wstarzak/quickTuneHF/imgs/CPU_board.png

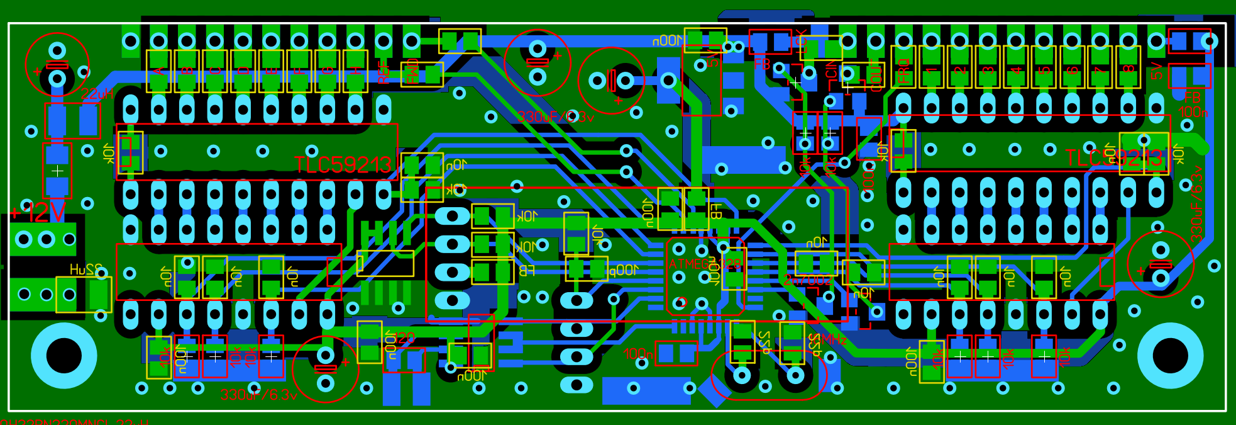
imgs/CPU_board.png
