wstarzak/quickTuneHF/imgs/IMG_8424.JPG

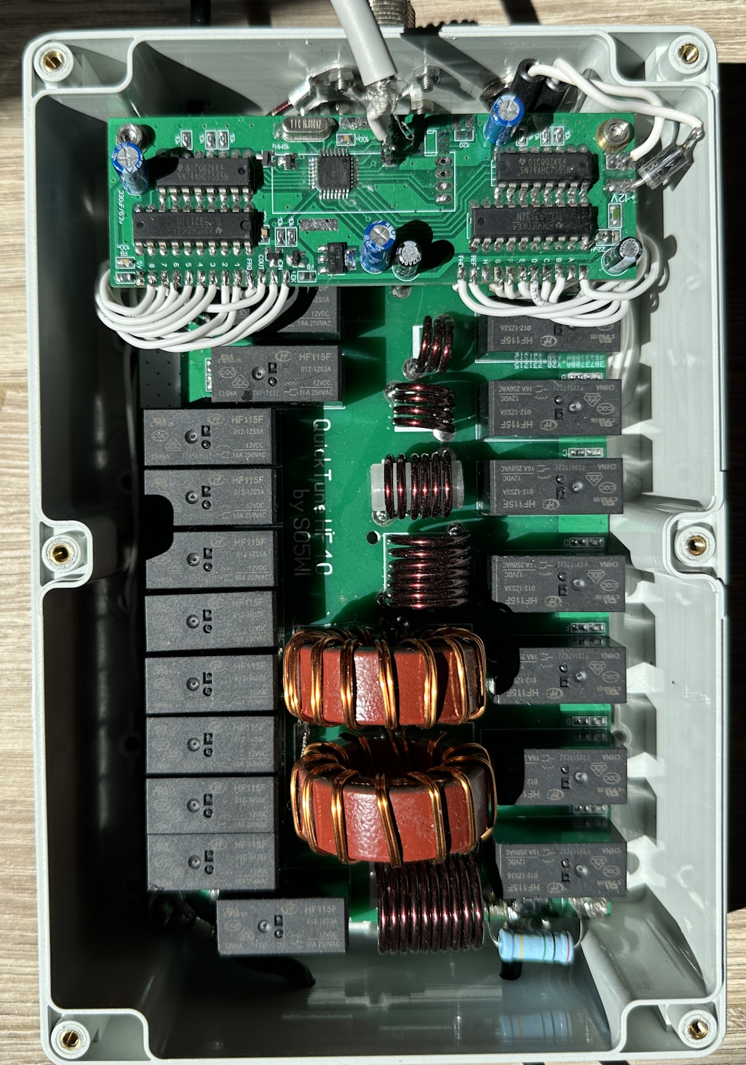
imgs/IMG_8424.JPG
