wstarzak/quickTuneHF/imgs/IMG_8435.JPG

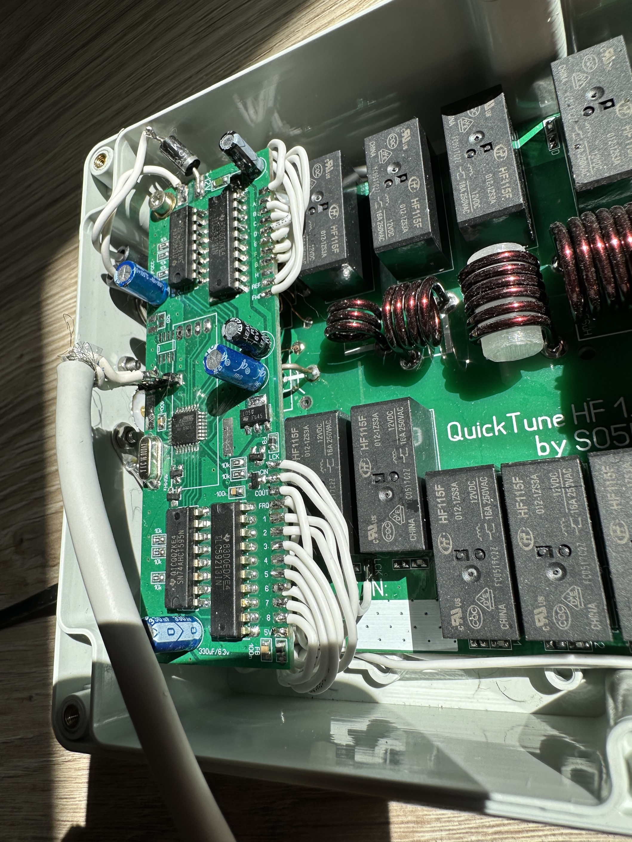
imgs/IMG_8435.JPG
