wstarzak/quickTuneHF/imgs/IMG_8436.JPG

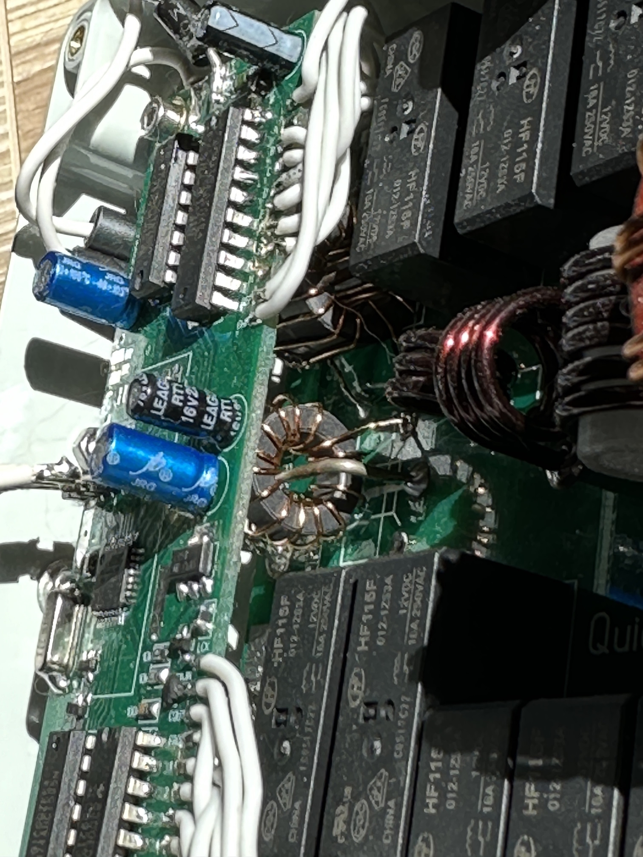
imgs/IMG_8436.JPG
