wstarzak/quickTuneHF/imgs/mainboard.JPG

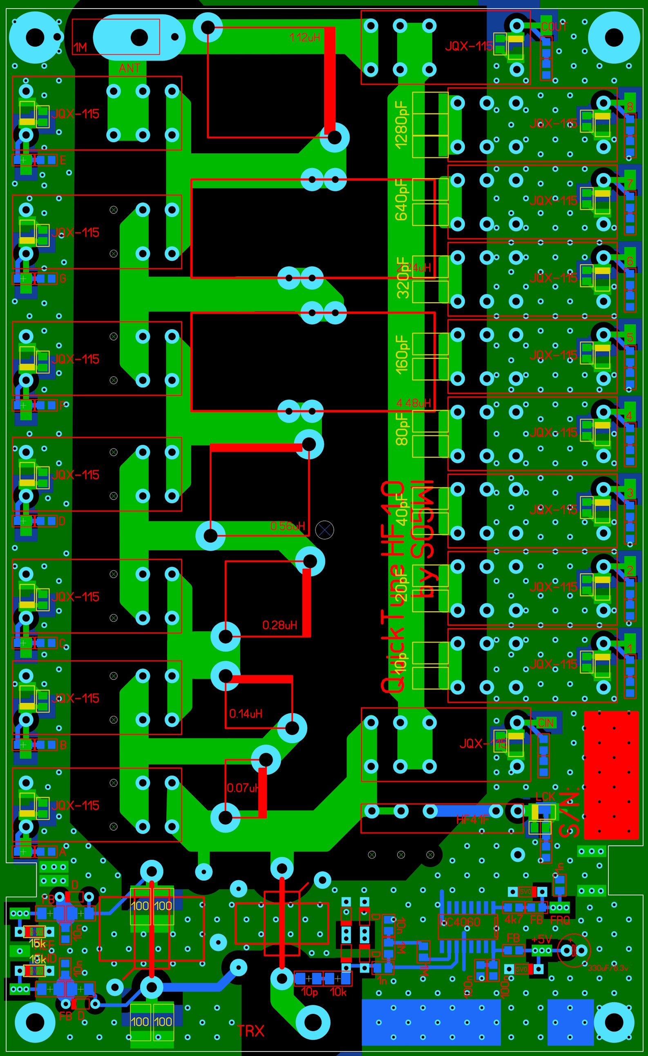
imgs/mainboard.JPG
