wstarzak/quickTuneHF/imgs/SGC230det.gif

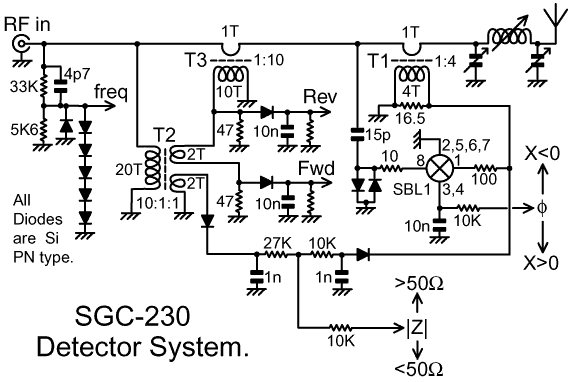
imgs/SGC230det.gif
