wstarzak/quickTuneHF/(list of files, drawings)

Other design files:
quickTuneHF.lay6
