wstarzak/quickTuneHF/src/include/pinout.h

#define SER_PIN_L 17   // pin 14 on the 75HC595
#define RCLK_PIN_L 16  // pin 12 on the 75HC595
#define SRCLK_PIN_L 15 // pin 11 on the 75HC595
#define TLC_PIN_L 13

#define SER_PIN_C 11  // pin 14 on the 75HC595
#define RCLK_PIN_C 10 // pin 12 on the 75HC595
#define SRCLK_PIN_C 9 // pin 11 on the 75HC595
#define TLC_PIN_C 12

#define C_IN_PIN 7
#define C_OUT_PIN 8

#define SWR_REF_PIN A7
#define SWR_FWD_PIN A0
