wstarzak/quickTuneHF/(commit log)

2024-08-05 Fixed algorithm, tuning steps varies depending on frequency
    [main.cpp]
2026-03-05 chore: vibecoded a bit to fix issues
    [main.cpp]
2026-03-16 diode correction
